limpkin/capmeter/README.md

Capacitance Meter
=================
Project in development

Things to be included with the capmeter
---------------------------------------
- <a href="http://www.ebay.com/itm/SE-N-SMD-Inductor-Test-Clip-Probe-Tweezers-for-Resistor-Multimeter-Capacitor-/111412611628">SMD tweezers</a>  
- <a href="http://www.ebay.com/itm/1Pair-For-Multimeter-Test-Equipment-Banana-Plug-To-Test-Hook-Clip-Probe-Cable-/311330430002">test hooks</a>
- one 1pF SMD capacitor
