limpkin/capmeter/bootloader/README.md

Capacitance Meter Bootloader
=============================

The bootloader found here (atxmega16a4u_104_modified.hex) has been made by modifying the Atmel provided bootloader file (atxmega16a4u_104.hex) using the following technique: http://www.hilltop-cottage.info/blogs/adam/xmega-dfu-bootloader-changing-the-sensing-pin/
