limpkin/capmeter/schematics/bom_capacitance_meter.xlsm

Project Bill Of Materials
 | Prototype quantity : | 100
Item | Schematics Ref | Qty | Price/chip | Total Price | Home Stock | Digikey Stock | Description | Manufacturer P/N | Manufacturer | Packaging | Internet link | Category | Family | (Value)
1 | U4 | 1 | 2.4824 | 2.4824 | 0 | 2775 | IC MULTIPLEXER 4X1 10MSOP | ADG804YRMZ-REEL7 | Analog Devices Inc. | 10-MSOP | http://www.digikey.com/product-detail/en/ADG804YRMZ-REEL7/ADG804YRMZ-REEL7CT-ND/3674772 | Integrated Circuits (ICs) | Interface - Analog Switches, Multiplexers, Demultiplexers
2 | U2 | 1 | 1.35 | 1.35 | 0 | 12525 | IC OPAMP GP 50MHZ RRO SOT23-5 | OPA365AIDBVR | Texas Instruments | SOT-23-5 | http://www.digikey.com/product-detail/en/OPA365AIDBVR/296-20645-1-ND/1133683 | Integrated Circuits (ICs) | Linear - Amplifiers - Instrumentation, OP Amps, Buffer Amps
3 | U7 | 1 | 1.4637 | 1.4637 | 0 | 74 | IC OPAMP LOW POWER SOT23-6 | MAX44284HAUT+T | Maxim Integrated | SOT-23-6 | http://www.digikey.com/product-detail/en/MAX44284HAUT%2BT/MAX44284HAUT%2BTCT-ND/4967871 | Integrated Circuits (ICs) | Linear - Amplifiers - Instrumentation, OP Amps, Buffer Amps
4 | U5 U8 | 2 | 2.29 | 4.58 | 0 | 14680 | IC REG LDO ADJ 0.15A 8MSOP | TPS7A4901DGNR | Texas Instruments | 8-MSOP-PowerPad | http://www.digikey.com/product-detail/en/TPS7A4901DGNR/296-27751-1-ND/2361068 | Integrated Circuits (ICs) | PMIC - Voltage Regulators - Linear
5 | U1 | 1 | 1.02 | 1.02 | 0 | 10071 | IC REG BOOST ADJ 1A SYNC 10-LLP | LM4510SD/NOPB | Texas Instruments | 10-SON (3x3) | http://www.digikey.com/product-detail/en/LM4510SD%2FNOPB/LM4510SD%2FNOPBCT-ND/1679844 | Integrated Circuits (ICs) | PMIC - Voltage Regulators - DC DC Switching Regulators
6 | U3 | 1 | 0.3584 | 0.3584 | 0 | 10944 | IC VREF SHUNT ADJ SOT23-3 | TS3431CILT | STMicroelectronics | SOT-23-3 | http://www.digikey.com/product-detail/en/TS3431CILT/497-4637-1-ND/806501 | Integrated Circuits (ICs) | PMIC - Voltage Reference
7 | U10 | 1 | 0.8058 | 0.8058 | 0 | 10801 | IC VREF SHUNT ADJ TSOT23-5 | CAT102TDI-GT3 | ON Semiconductor | TSOT-23-5 | http://www.digikey.com/product-detail/en/CAT102TDI-GT3/CAT102TDI-GT3OSCT-ND/3487509 | Integrated Circuits (ICs) | PMIC - Voltage Reference
8 | U6 | 1 | 2.5498 | 2.5498 | 0 | 9928 | IC MCU 8BIT 16KB FLASH 44VQFN | ATXMEGA16A4U-MHR | Atmel | 44-VQFN (7x7) | http://www.digikey.com/product-detail/en/ATXMEGA16A4U-MHR/ATXMEGA16A4U-MHRCT-ND/3441033 | Integrated Circuits (ICs) | Embedded - Microcontrollers
9 | U11 | 1 | 3.13 | 3.13 |  | 10217 | IC COMPARATOR R-R HI-SPD SOT23-8 | TLV3502AIDCNT | Texas Instruments | SOT-23-8 | http://www.digikey.com/product-detail/en/TLV3502AIDCNT/296-18147-1-ND/773322 | Integrated Circuits (ICs) | Linear - Comparators
10 | U12 | 1 | 0.134 | 0.134 |  | 21783 | IC GATE AND 1CH 2-INP SC-70-5 | SN74LVC1G08DCKR | Texas Instruments | 5-TSSOP, SC-70-5, SOT-353 | http://www.digikey.com/product-detail/en/SN74LVC1G08DCKR/296-11602-1-ND/385741 | Integrated Circuits (ICs) | Logic - Gates and Inverters
11 | D2 D4 | 2 | 0.2305 | 0.461 | 0 | 10598 | TVS DIODE 24VWM 76VC SOT23 | PESD24VU1UT,215 | NXP Semiconductors | SOT-23 (TO-236AB) | http://www.digikey.com/product-detail/en/PESD24VU1UT,215/568-4039-1-ND/1530829 | Circuit Protection | TVS - Diodes
12 | U9 | 1 | 0.2633 | 0.2633 | 0 | 49052 | TVS DIODE 5.5VWM 6TSOP | IP4234CZ6,125 | NXP Semiconductors | 6-TSOP | http://www.digikey.com/product-detail/en/IP4234CZ6,125/568-5869-1-ND/2531156 | Circuit Protection | TVS - Diodes
13 | CON1 | 1 | 0.3032 | 0.3032 | 0 | 88133 | Connector Receptacle USB - micro B 2.0 5 Position Surface Mount, Right Angle, Horizontal | 10118194-0001LF | FCI |  | http://www.digikey.com/product-detail/en/10118194-0001LF/609-4618-1-ND/2785382 | Connectors, Interconnects | USB, DVI, HDMI Connectors
14 | NOT POPULATED | 2 | 4.5 | 9 | 0 | 147 | SOCKET SCREW-IN SAFETY RED | BU-31607-2 | Mueller Electric Co |  | http://www.digikey.com/product-detail/en/BU-31607-2/314-1218-ND/2688311 | Connectors, Interconnects | Banana and Tip Connectors - Jacks, Plugs
15 | NOT POPULATED | 2 | 4.5 | 9 | 0 | 182 | SOCKET SCREW-IN SAFETY BLACK | BU-31607-0 | Mueller Electric Co |  | http://www.digikey.com/product-detail/en/BU-31607-0/314-1217-ND/2688310 | Connectors, Interconnects | Banana and Tip Connectors - Jacks, Plugs
16 | Q4 | 1 | 0.2117 | 0.2117 | 0 | 109281 | MOSFET P-CH 20V 2.2A SOT23-3 | SI2301BDS-T1-E3 | Vishay Siliconix | SOT-23-3 (TO-236) | http://www.digikey.com/product-detail/en/SI2301BDS-T1-E3/SI2301BDS-T1-E3CT-ND/1656835 | Discrete Semiconductor Products | FETs - Single
17 | Q1 Q2 Q3 Q5 | 4 | 0.1468 | 0.5872 | 0 | 20844 | MOSFET N-CH 20V 0.1A VMT3 | RUM001L02T2CL | Rohm Semiconductor | VMT3 | http://www.digikey.com/product-detail/en/RUM001L02T2CL/RUM001L02T2CLCT-ND/4571412 | Discrete Semiconductor Products | FETs - Single
18 | D1 | 1 | 0.2102 | 0.2102 | 0 | 189027 | DIODE SCHOTTKY 20V 1A SOD123F | PMEG2010AEH,115 | NXP Semiconductors | SOD-123F | http://www.digikey.com/product-detail/en/PMEG2010AEH,115/568-4112-1-ND/1589927 | Discrete Semiconductor Products | Diodes, Rectifiers - Single
19 | X1 | 1 | 0.6255 | 0.6255 | 0 | 15064 | Crystal 32.7680kHz 10ppm 12.5pF 70 kOhm -40°C - 85°C Surface Mount 1206 (3216 Metric) | CM315D32768EZFT | Citizen Finedevice Co Ltd | 1206 (3216 Metric) | http://www.digikey.com/product-detail/en/CM315D32768EZFT/300-8816-1-ND/3641389 | Crystals and Oscillators | Crystals | 12.5pF
20 | C37 | 1 | 0.2387 | 0.2387 | 0 | 40636 | CAP ALUM 330UF 20% 25V SMD | UWT1E331MNL1GS | Nichicon | Radial, Can - SMD | http://www.digikey.com/product-detail/en/UWT1E331MNL1GS/493-2193-1-ND/590168 | Capacitors | Aluminum Capacitors | 330µF
21 | C2 C5 C27 C31 C32 C35 C36 C38 | 8 | 0.06226 | 0.49808 | 0 | 362972 | CAP CER 10UF 16V X5R 0805 | CL21A106KOQNNNE | Samsung Electro-Mechanics America, Inc. | 0805 (2012 Metric) | http://www.digikey.com/product-detail/en/CL21A106KOQNNNE/1276-1096-1-ND/3889182 | Capacitors | Ceramic Capacitors | 10µF
22 | C10 C11 C20 C22 C23 | 5 | 0.06758 | 0.3379 | 0 | 329508 | CAP CER 10UF 25V X5R 1206 | CL31A106KAHNNNE | Samsung Electro-Mechanics America, Inc. | 1206 (3216 Metric) | http://www.digikey.com/product-detail/en/CL31A106KAHNNNE/1276-1075-1-ND/3889161 | Capacitors | Ceramic Capacitors | 10µF
23 | C6 C28 C33 | 3 | 0.0187 | 0.0561 | 0 | 394394 | CAP CER 1UF 10V X7R 0603 | CL10B105KP8NNNC | Samsung Electro-Mechanics America, Inc. | 0603 (1608 Metric) | http://www.digikey.com/product-detail/en/CL10B105KP8NNNC/1276-1946-1-ND/3890032 | Capacitors | Ceramic Capacitors | 1µF
24 | C1 C3 C8 C12 C13 C14 C15 C18 C19 C34 C39 C40 C41 C42 | 14 | 0.00681 | 0.09534 | 0 | 7307571 | CAP CER 0.1UF 50V X7R 0603 | CL10B104KB8NNNC | Samsung Electro-Mechanics America, Inc. | 0603 (1608 Metric) | http://www.digikey.com/product-detail/en/CL10B104KB8NNNC/1276-1000-1-ND/3889086 | Capacitors | Ceramic Capacitors | 0.1µF
25 | C4 C16 C17 C29 C30 | 5 | 0.0059 | 0.0295 | 0 | 632752 | CAP CER 10000PF 50V X7R 0603 | CL10B103KB8NCNC | Samsung Electro-Mechanics America, Inc. | 0603 (1608 Metric) | http://www.digikey.com/product-detail/en/CL10B103KB8NCNC/1276-1921-1-ND/3890007 | Capacitors | Ceramic Capacitors | 10000pF
26 | C26 | 1 | 0.0118 | 0.0118 | 0 | 145080 | CAP CER 4700PF 50V X7R 0603 | CL10B472KB8SFNC | Samsung Electro-Mechanics America, Inc. | 0603 (1608 Metric) | http://www.digikey.com/product-detail/en/CL10B472KB8SFNC/1276-2066-1-ND/3890152 | Capacitors | Ceramic Capacitors | 4700pF
27 | C9 | 1 | 0.0132 | 0.0132 | 0 | 207490 | CAP CER 2200PF 50V X7R 0603 | CL10B222KB8SFNC | Samsung Electro-Mechanics America, Inc. | 0603 (1608 Metric) | http://www.digikey.com/product-detail/en/CL10B222KB8SFNC/1276-1992-1-ND/3890078 | Capacitors | Ceramic Capacitors | 2200pF
28 | C21 | 1 | 0.0121 | 0.0121 | 0 | 561107 | CAP CER 100PF 50V NP0 0603 | CL10C101JB8NNNC | Samsung Electro-Mechanics America, Inc. | 0603 (1608 Metric) | http://www.digikey.com/product-detail/en/CL10C101JB8NNNC/1276-1008-1-ND/3889094 | Capacitors | Ceramic Capacitors | 100pF
29 | C7 | 1 | 0.0121 | 0.0121 | 0 | 299855 | CAP CER 15PF 50V NP0 0603 | CL10C150JB8NNNC | Samsung Electro-Mechanics America, Inc. | 0603 (1608 Metric) | http://www.digikey.com/product-detail/en/CL10C150JB8NNNC/1276-1296-1-ND/3889382 | Capacitors | Ceramic Capacitors | 15pF
30 | L1 | 1 | 0.2243 | 0.2243 | 0 | 122811 | FIXED IND 4.7UH 3A 40.3 MOHM SMD | NR6028T4R7M | Taiyo Yuden | - | http://www.digikey.com/product-detail/en/NR6028T4R7M/587-2100-1-ND/1866240 | Inductors, Coils, Chokes | Fixed Inductors | 4.7µH
31 | R24 | 1 | 0.0071 | 0.0071 | 0 | 1176822 | RES SMD 1M OHM 5% 1/10W 0603 | ERJ-3GEYJ105V | Panasonic Electronic Components | 603 | http://www.digikey.com/product-detail/en/ERJ-3GEYJ105V/P1.0MGCT-ND/134885 | Resistors | Chip Resistor - Surface Mount | 1M
32 | R7 | 1 | 0.0084 | 0.0084 | 0 | 26809 | RES SMD 255K OHM 1% 1/10W 0603 | ERJ-3EKF2553V | Panasonic Electronic Components | 603 | http://www.digikey.com/product-detail/en/ERJ-3EKF2553V/P255KHCT-ND/198279 | Resistors | Chip Resistor - Surface Mount | 255k
33 | R16 | 1 | 0.1612 | 0.1612 | 0 | 117942 | RES SMD 100K OHM 0.1% 1/10W 0603 | RG1608P-104-B-T5 | Susumu | 603 | http://www.digikey.com/product-detail/en/RG1608P-104-B-T5/RG16P100KBCT-ND/1240836 | Resistors | Chip Resistor - Surface Mount | 100k
34 | R5 R8 | 2 | 0.0084 | 0.0168 | 0 | 135609 | RES SMD 46.4K OHM 1% 1/10W 0603 | ERJ-3EKF4642V | Panasonic Electronic Components | 603 | http://www.digikey.com/product-detail/en/ERJ-3EKF4642V/P46.4KHCT-ND/198400 | Resistors | Chip Resistor - Surface Mount | 46.4k
35 | R9 R33 | 2 | 0.0057 | 0.0114 | 0 | 1048463 | RES SMD 20.5K OHM 1% 1/10W 0603 | RC0603FR-0720K5L | Yageo | 603 | http://www.digikey.com/product-detail/en/RC0603FR-0720K5L/311-20.5KHRCT-ND/729989 | Resistors | Chip Resistor - Surface Mount | 20.5k
36 | R4 R17 | 2 | 0.0057 | 0.0114 | 0 | 1043691 | RES SMD 15K OHM 1% 1/10W 0603 | RC0603FR-0715KL | Yageo | 603 | http://www.digikey.com/product-detail/en/RC0603FR-0715KL/311-15.0KHRCT-ND/729900 | Resistors | Chip Resistor - Surface Mount | 15k
37 | R22 | 1 | 0.1924 | 0.1924 | 0 | 81686 | RES SMD 15K OHM 0.1% 1/10W 0603 | ERA-3AEB153V | Panasonic Electronic Components | 603 | http://www.digikey.com/product-detail/en/ERA-3AEB153V/P15KDBCT-ND/1466080 | Resistors | Chip Resistor - Surface Mount | 15k
38 | R15 | 1 | 0.1612 | 0.1612 | 0 | 353464 | RES SMD 10K OHM 0.1% 1/10W 0603 | RG1608P-103-B-T5 | Susumu | 603 | http://www.digikey.com/product-detail/en/RG1608P-103-B-T5/RG16P10.0KBCT-ND/1240835 | Resistors | Chip Resistor - Surface Mount | 10k
39 | R1 R11 R12 R19 R25 R28 R31 R32 R38 | 9 | 0.00348 | 0.03132 | 0 | 10884953 | RES SMD 10K OHM 1% 1/10W 0603 | RC0603FR-0710KL | Yageo | 603 | http://www.digikey.com/product-detail/en/RC0603FR-0710KL/311-10.0KHRCT-ND/729827 | Resistors | Chip Resistor - Surface Mount | 10k
40 | R34 R35 | 2 | 0.0057 | 0.0114 |  | 186024 | RES SMD 5.49K OHM 1% 1/10W 0603 | RC0603FR-075K49L | Yageo | 603 | http://www.digikey.com/product-detail/en/RC0603FR-075K49L/311-5.49KHRCT-ND/730221 | Resistors | Chip Resistor - Surface Mount | 5.49k
41 | R26 | 1 | 0.0084 | 0.0084 | 0 | 93154 | RES SMD 2.15K OHM 1% 1/10W 0603 | ERJ-3EKF2151V | Panasonic Electronic Components | 603 | http://www.digikey.com/product-detail/en/ERJ-3EKF2151V/P2.15KHCT-ND/198222 | Resistors | Chip Resistor - Surface Mount | 2.15k
42 | R2 R10 R18 R27 R29 R37 | 6 | 0.00514 | 0.03084 | 0 | 238457 | RES SMD 1.2K OHM 1% 1/10W 0603 | ERJ-3EKF1201V | Panasonic Electronic Components | 603 | http://www.digikey.com/product-detail/en/ERJ-3EKF1201V/P1.20KHCT-ND/1746727 | Resistors | Chip Resistor - Surface Mount | 1.2k
43 | R23 | 1 | 0.1924 | 0.1924 | 0 | 141597 | RES SMD 1.2K OHM 0.1% 1/10W 0603 | ERA-3AEB122V | Panasonic Electronic Components | 603 | http://www.digikey.com/product-detail/en/ERA-3AEB122V/P1.2KDBCT-ND/1466054 | Resistors | Chip Resistor - Surface Mount | 1.2k
44 | R36 | 1 | 0.0084 | 0.0084 |  | 5659865 | RES SMD 1K OHM 1% 1/10W 0603 | ERJ-3EKF1001V | Panasonic Electronic Components | 603 | http://www.digikey.com/product-detail/en/ERJ-3EKF1001V/P1.00KHCT-ND/198071 | Resistors | Chip Resistor - Surface Mount | 1k
45 | R21 | 1 | 0.1924 | 0.1924 | 0 | 136190 | RES SMD 1K OHM 0.1% 1/10W 0603 | ERA-3AEB102V | Panasonic Electronic Components | 603 | http://www.digikey.com/product-detail/en/ERA-3AEB102V/P1.0KDBCT-ND/1466052 | Resistors | Chip Resistor - Surface Mount | 1k
46 | R14 | 1 | 0.2554 | 0.2554 |  | 14275 | RES SMD 1K OHM 0.1% 1/4W 1206 | RG3216P-1001-B-T1 | Susumu | 1206 | http://www.digikey.com/product-detail/en/RG3216P-1001-B-T1/RG32P1.0KBCT-ND/2078593 | Resistors | Chip Resistor - Surface Mount | 1k
47 | R13 | 1 | 0.6187 | 0.6187 | 0 | 9696 | RES SMD 470 OHM 0.1% 1W 1206 | PRG3216P-4700-B-T5 | Susumu | 1206 | http://www.digikey.com/product-detail/en/PRG3216P-4700-B-T5/408-1862-1-ND/4917843 | Resistors | Chip Resistor - Surface Mount | 470
48 | R3 R6 R30 | 3 | 0.00436 | 0.01308 | 0 | 2031519 | RES SMD 100 OHM 1% 1/10W 0603 | RC0603FR-07100RL | Yageo | 603 | http://www.digikey.com/product-detail/en/RC0603FR-07100RL/311-100HRCT-ND/729835 | Resistors | Chip Resistor - Surface Mount | 100
49 | R20 | 1 | 0.0096 | 0.0096 | 0 | 8523170 | RES SMD 0.0OHM JUMPER 1/10W 0603 | ERJ-3GEY0R00V | Panasonic Electronic Components | 603 | http://www.digikey.com/product-detail/en/ERJ-3GEY0R00V/P0.0GCT-ND/134711 | Resistors | Chip Resistor - Surface Mount | 0
50 | FB1 | 1 | 0.0472 | 0.0472 | 0 | 607973 | FERRITE CHIP 220 OHM 2A 0603 | MPZ1608S221ATA00 | TDK Corporation | 0603 (1608 Metric) | http://www.digikey.com/product-detail/en/MPZ1608S221ATA00/445-1565-1-ND/571895 | Filters | Ferrite Beads and Chips
 | CON2 | 1 |  |  |  |  | Standard 0.1" connector 3x2
 | P6 | 1 |  |  |  |  | Standard 0.1" connector 4x1
 | C24 C25 |  |  |  |  |  | DO NOT POPULATE
 | Total: | 108 |  | 42.05436
 | Total for 10 prototypes : |  |  | 53.907
 | Total for 100 prototypes : |  |  | 42.05436 |  | Missing in Kicad: NOT_POPULATED NOT_POPULATED
 | Total for 1000 prototypes : |  |  | 32.50572 |  | Missing in BoM: P1 P2 P3 P4 P7 P8 P9
 | Total for 5000 prototypes : |  |  | 30.76193
 | Total for 10k "prototypes" : |  |  | 30.76193
