limpkin/capmeter/(threads)

Thread 2 (2015-12-15):

Macro enabled BOM is a security risk

duckythescientist, 2015-12-15:
File in question: `capmeter/schematics/bom_capacitance_meter.xlsm`

This is a macro enabled Excel spread sheet which has the ability to execute code on a host machine. I'm guessing that VB scripts in this are fully benign and probably useful/necessary for the project, but it's still a worry. Office has removed autorun capabilities for document macros, so it's not a huge issue anymore.

It would be best to remove the macro if you can maintain functionality of the document. I'm guessing the macro is integral enough that this issue should be marked "wontfix".

--------
[Why macros are dangerous](http://www.howtogeek.com/171993/macros-explained-why-microsoft-office-files-can-be-dangerous/)

[Extracting macros from documents for analysis](https://digital-forensics.sans.org/blog/2009/11/23/extracting-vb-macros-from-malicious-documents)
