limpkin/capmeter/schematics/schematics.pdf

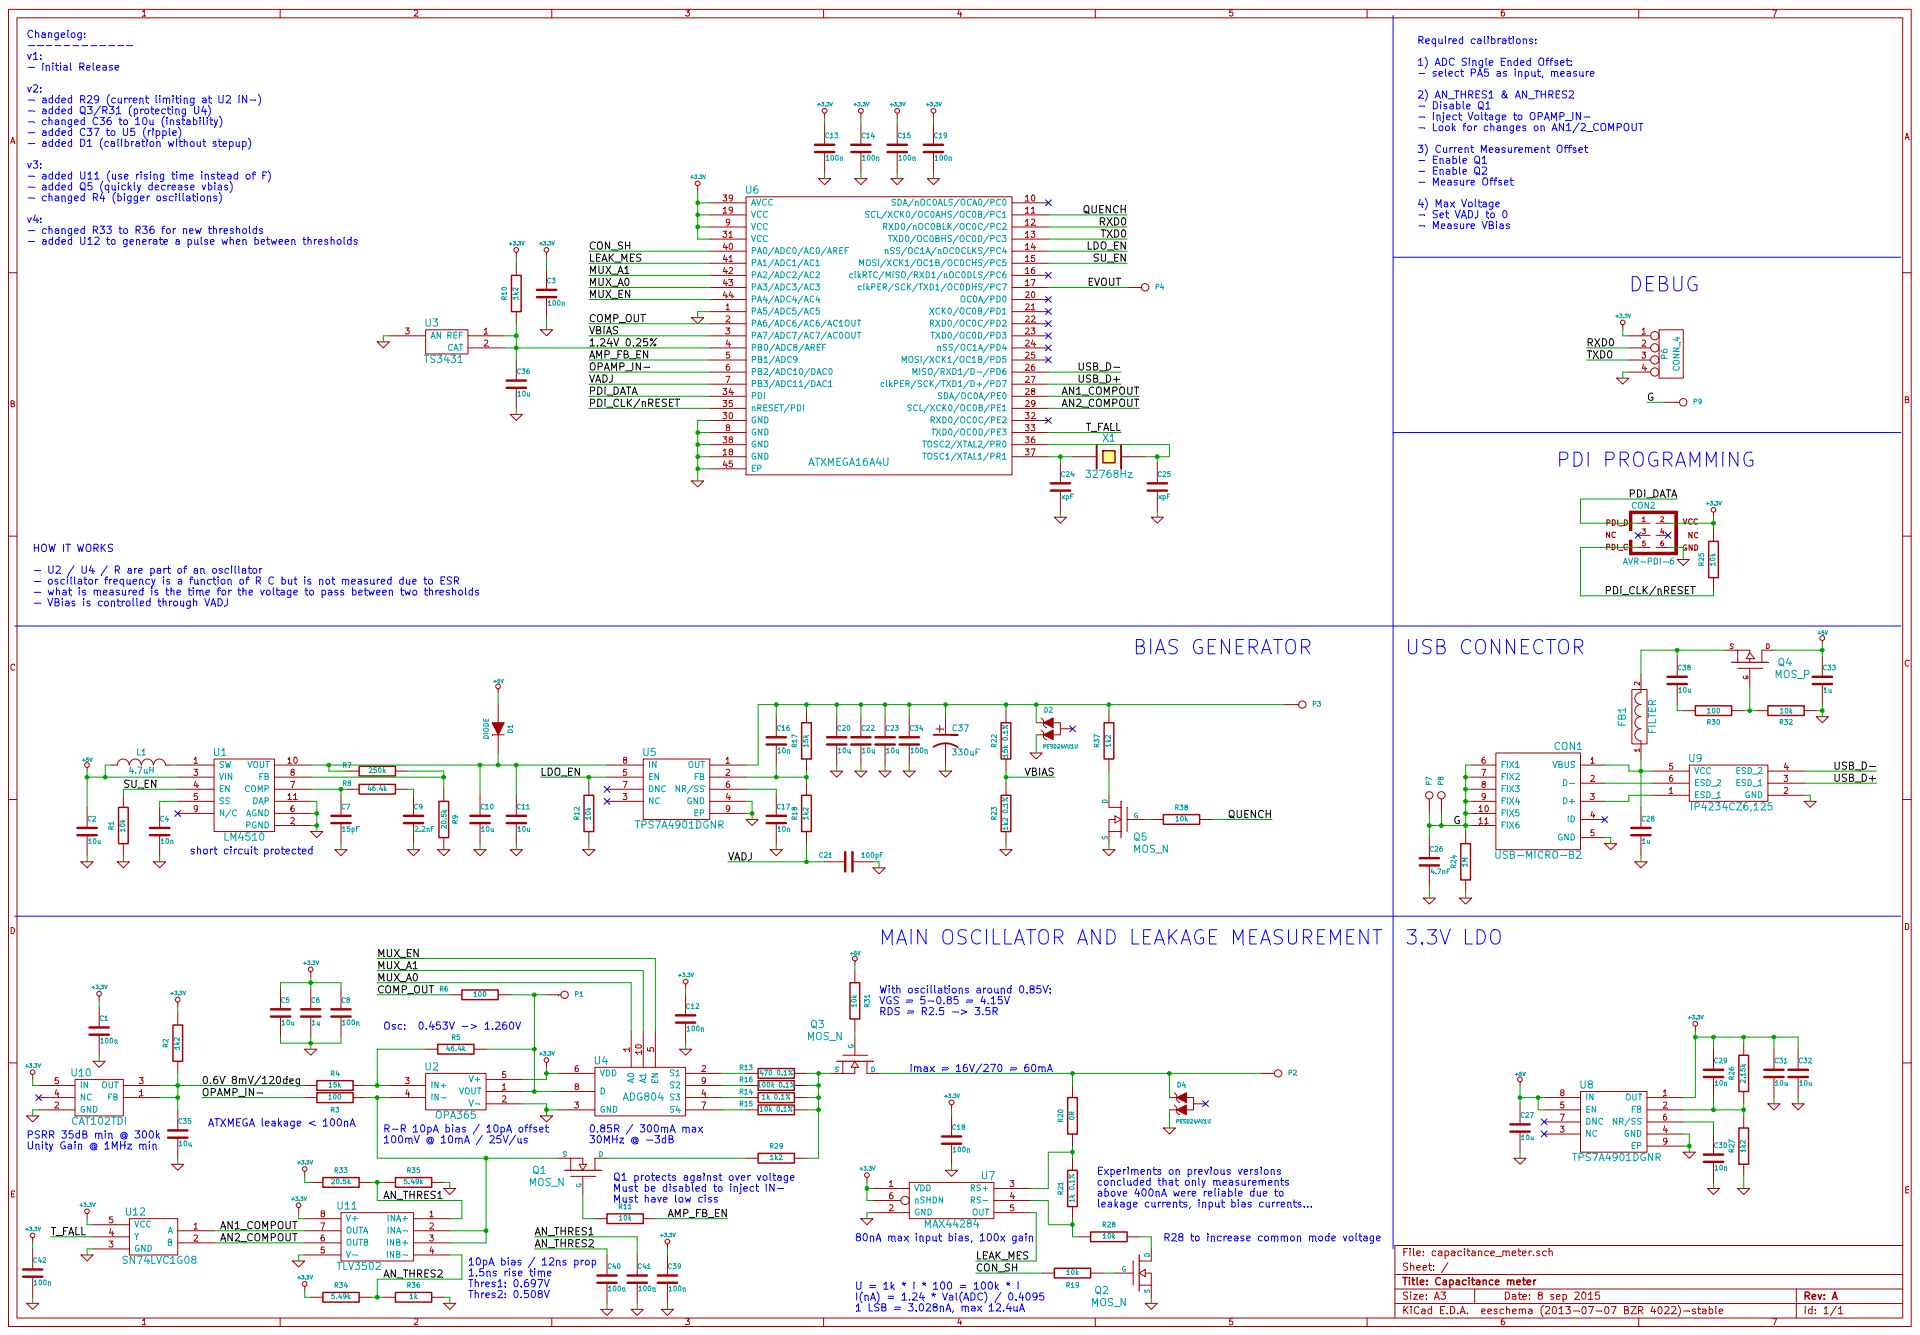
[picture p1: page 1]
