limpkin/capmeter/source_code/printf_override.h

/*
 * printf_override.h
 *
 * Created: 23/07/2015 20:11:53
 *  Author: limpkin
 */ 


#ifndef PRINTF_OVERRIDE_H_
#define PRINTF_OVERRIDE_H_

#define PRINTF_OVERRIDE
#ifdef PRINTF_OVERRIDE
    #undef IO_PRINTF
    #undef SERIAL_PRINTF
    #undef MEAS_PRINTF
    #undef DAC_PRINTF
    #undef ADC_PRINTF
    #undef CALIB_PRINTF
    #undef VBIAS_PRINTF
    #undef MAIN_PRINTF
#endif

// This file was made to facilitate automated testing through uart
//#undef AUTOMATED_TESTS_PRINTF
//#undef TESTS_PRINTF
//#undef CONV_PRINTF

#endif /* PRINTF_OVERRIDE_H_ */
