limpkin/capmeter/source_code/usb.h

/*
 *  usb.h
 *  Author: Miguel
 */
#ifndef USB_H_
#define USB_H_

#include <avr/io.h>
#include "defines.h"
#include "printf_override.h"

/* Function prototypes */
void init_usb(void);
uint8_t is_usb_enumerated(void);
void usb_send_data(uint8_t* data);
uint8_t usb_receive_data(uint8_t* data);

// USB printf
#ifdef USB_PRINTF
    #define usbdprintf   printf
    #define usbdprintf_P printf_P
#else
    #define usbdprintf
    #define usbdprintf_P
#endif

// Typedefs
typedef union USB_EP_pair
{
    union
    {
        struct
        {
            USB_EP_t out;
            USB_EP_t in;
        };
        USB_EP_t ep[2];
    };
} __attribute__ ((packed)) USB_EP_pair_t;

// Configuration descriptor, USB spec 9.6.3, page 264-266, Table 9-10
#define RAWHID_INTERFACE    0                   // Interface for the raw HID
#define RAWHID_RX_ENDPOINT  1                   // Raw HID RX endpoint
#define RAWHID_TX_ENDPOINT  2                   // Raw HID TX endpoint
#define RAWHID_TX_SIZE      64                  // Raw HID transmit packet size
#define RAWHID_RX_SIZE      64                  // Raw HID receive packet size
#define RAWHID_RX_INTERVAL  10                  // RX interval
#define RAWHID_TX_INTERVAL  10                  // TX interval
#define RAWHID_USAGE_PAGE   0xFF31              // HID usage page, after 0xFF00: vendor-defined
#define RAWHID_USAGE        0x0074              // HID usage
#define RAWHID_EP0_SIZE     64                  // Endpoint 0 size

// Command IDs defines
#define CMD_DEBUG               0x00
#define CMD_PING                0x01
#define CMD_VERSION             0x02
#define CMD_OE_CALIB_STATE      0x03
#define CMD_OE_CALIB_START      0x04
#define CMD_GET_OE_CALIB        0x05
#define CMD_SET_VBIAS           0x06
#define CMD_DISABLE_VBIAS       0x07
#define CMD_CUR_MES_MODE        0x08
#define CMD_CUR_MES_MODE_EXIT   0x09
#define CMD_CAP_REPORT_FREQ     0x0A
#define CMD_CAP_MES_START       0x0B
#define CMD_CAP_MES_REPORT      0x0C
#define CMD_CAP_MES_EXIT        0x0D
#define CMD_SET_VBIAS_DAC       0x0E
#define CMD_RESET_STATE         0x0F
#define CMD_SET_EEPROM_VALS     0x10
#define CMD_READ_EEPROM_VALS    0x11

#define CMD_BOOTLOADER_START    0xFF

#define USB_RETURN_ERROR    0
#define USB_RETURN_OK       1

/* USB Calibration Offsets */
#define USBCAL0_offset      (0x1A)
#define USBCAL1_offset      (0x1B)

#endif
