limpkin/capmeter/scripts/hid_comms.py

from array import array
from time import sleep
import platform
import usb.core
import usb.util
import os.path
import random
import struct
import string
import pickle
import copy
import time
import sys
import os

USB_VID                 = 0x1209
USB_PID                 = 0xdddd

LEN_INDEX               = 0x00
CMD_INDEX               = 0x01
DATA_INDEX              = 0x02
CMD_PING		= 0x05

		
def receiveHidPacket(epin):
	try :
		data = epin.read(epin.wMaxPacketSize, timeout=15000)
		return data
	except usb.core.USBError as e:
		#print e
		sys.exit("Capmeter didn't send a packet")

def receiveHidPacketWithTimeout(epin):
	try :
		data = epin.read(epin.wMaxPacketSize, timeout=15000)
		return data
	except usb.core.USBError as e:
		return None

def sendHidPacket(epout, cmd, len, data):
	# data to send
	arraytosend = array('B')

	# if command copy it otherwise copy the data
	if cmd != 0:
		arraytosend.append(len)
		arraytosend.append(cmd)

	# add the data
	if data is not None:
		arraytosend.extend(data)

	#print arraytosend
	#print arraytosend

	# send data
	epout.write(arraytosend)
	
def findHIDDevice(vendor_id, product_id, print_debug):
	# Find our device
	hid_device = usb.core.find(idVendor=vendor_id, idProduct=product_id)

	# Was it found?
	if hid_device is None:
		if print_debug:
			print "Device not found"
		return None, None, None, None

	# Device found
	if print_debug:
		print "Capmeter found"

	# Different init codes depending on the platform
	if platform.system() == "Linux":
		# Need to do things differently
		try:
			print ""
			hid_device.detach_kernel_driver(0)
			#hid_device.reset()
		except Exception, e:
			pass # Probably already detached
	else:
		# Set the active configuration. With no arguments, the first configuration will be the active one
		try:
			hid_device.set_configuration()
		except Exception, e:
			if print_debug:
				print "Cannot set configuration the device:" , str(e)
			return None, None, None, None

	#for cfg in hid_device:
	#	print "configuration val:", str(cfg.bConfigurationValue)
	#	for intf in cfg:
	#		print "int num:", str(intf.bInterfaceNumber), ", int alt:", str(intf.bAlternateSetting)
	#		for ep in intf:
	#			print "endpoint addr:", str(ep.bEndpointAddress)

	# Get an endpoint instance
	cfg = hid_device.get_active_configuration()
	intf = cfg[(0,0)]

	# Match the first OUT endpoint
	epout = usb.util.find_descriptor(intf, custom_match = lambda e: usb.util.endpoint_direction(e.bEndpointAddress) == usb.util.ENDPOINT_OUT)
	if epout is None:
		hid_device.reset()
		return None, None, None, None
	#print "Selected OUT endpoint:", epout.bEndpointAddress

	# Match the first IN endpoint
	epin = usb.util.find_descriptor(intf, custom_match = lambda e: usb.util.endpoint_direction(e.bEndpointAddress) == usb.util.ENDPOINT_IN)
	if epin is None:
		hid_device.reset()
		return None, None, None, None
	#print "Selected IN endpoint:", epin.bEndpointAddress

	# prepare ping packet
	byte1 = random.randint(0, 255)
	byte2 = random.randint(0, 255)
	ping_packet = array('B')
	ping_packet.append(2)
	ping_packet.append(CMD_PING)
	ping_packet.append(byte1)
	ping_packet.append(byte2)

	time.sleep(0.5)
	try:
		# try to send ping packet
		epout.write(ping_packet)
		# try to receive one answer
		temp_bool = 0
		while temp_bool == 0:
			try :
				# try to receive answer
				data = epin.read(epin.wMaxPacketSize, timeout=2000)
				if data[CMD_INDEX] == CMD_PING and data[DATA_INDEX] == byte1 and data[DATA_INDEX+1] == byte2 :
					temp_bool = 1
					if print_debug:
						print "Capmeter replied to our ping message"
				else:
					if print_debug:
						print "Cleaning remaining input packets"
				time.sleep(.5)
			except usb.core.USBError as e:
				if print_debug:
					print e
				return None, None, None, None
	except usb.core.USBError as e:
		if print_debug:
			print e
		return None, None, None, None

	# Return device & endpoints
	return hid_device, intf, epin, epout

if __name__ == '__main__':
	# Main function
	print ""
	print "Capmeter USB client"

	# Search for the Capmeter and read hid data
	hid_device, intf, epin, epout = findHIDDevice(USB_VID, USB_PID, True)

	if hid_device is None:
		sys.exit(0)

	choice = 1
	while choice != 0:
		# print use
		print ""
		print "0) Quit"
		choice = input("Make your choice: ")
		print ""

		if choice == 1:
			print "pouet"

	hid_device.reset()
