limpkin/capmeter/source_code/tests.c

/*
 * tests.c
 *
 * Created: 24/07/2015 18:11:32
 *  Author: limpkin
 */ 
#include <avr/pgmspace.h>
#include <avr/eeprom.h>
#include <util/delay.h>
#include <avr/io.h>
#include <string.h>
#include <stdio.h>
#include "eeprom_addresses.h"
#include "conversions.h"
#include "calibration.h"
#include "measurement.h"
#include "meas_io.h"
#include "utils.h"
#include "vbias.h"
#include "tests.h"
#include "usb.h"
#include "dac.h"
#include "adc.h"

/*
 * To measure set voltages
 */
void functional_test(void)
{
    if (eeprom_read_byte((uint8_t*)EEP_FUNC_TEST_DONE_BOOL) == EEPROM_BOOL_OK_VAL)
    {
        // If functional test has already been done, return
        return;
    }        
    
    // Start by calibrating the platform
    testdprintf_P(PSTR("Calibration in progress, please wait...\r\n"));
    start_openended_calibration(0,0,0);
    
    testdprintf_P(PSTR("\r\n\r\n\r\n\r\n--------------------------\r\n"));
    testdprintf_P(PSTR("--- FUNCTIONAL TESTING ---\r\n"));
    testdprintf_P(PSTR("-\r\n"));
    uint8_t test_passed = TRUE;
    
    /*******************************************************************/
    /*******************************************************************/
    /******************** CHECK THE SINGLE ENDED OFFSET ****************/
    /*******************************************************************/
    /*******************************************************************/
    if (check_value_range(get_single_ended_offset(ADC_CHANNEL_GND_EXT), 160, 190) == FALSE)
    {
        testdprintf("- PROBLEM OFFSET: %u\r\n", get_single_ended_offset(ADC_CHANNEL_GND_EXT));
        testdprintf_P(PSTR("  Likely suspects: bad MCU\r\n"));
        test_passed = FALSE;
    } 
    else
    {
        testdprintf("- OK OFFSET: %u\r\n", get_single_ended_offset(ADC_CHANNEL_GND_EXT));
    }
    if (check_value_range(get_single_ended_offset(ADC_CHANNEL_VBIAS), 160, 190) == FALSE)
    {
        testdprintf("- PROBLEM OFFSET VBIAS: %u\r\n", get_single_ended_offset(ADC_CHANNEL_VBIAS));
        testdprintf_P(PSTR("  Likely suspects: bad MCU or defective U5/R22/R23\r\n"));
        test_passed = FALSE;
    } 
    else
    {
        testdprintf("- OK OFFSET VBIAS: %u\r\n", get_single_ended_offset(ADC_CHANNEL_VBIAS));
    }
    
    /*******************************************************************/
    /*******************************************************************/
    /********************* CHECK MAX VOLTAGE ***************************/
    /*******************************************************************/
    /*******************************************************************/
    if (get_max_vbias_voltage() < 15000)
    {
        testdprintf("- PROBLEM MAX VOLTAGE: %u\r\n", get_max_vbias_voltage());
        testdprintf_P(PSTR("  Likely suspects: U1, U5 and their passives\r\n"));
        test_passed = FALSE;
    } 
    else
    {
        testdprintf("- OK MAX VOLTAGE: %u\r\n", get_max_vbias_voltage());
    }
    
    /*******************************************************************/
    /*******************************************************************/
    /********************* CHECK THRESHOLD 1 ***************************/
    /*******************************************************************/
    /*******************************************************************/
    // Thres1: Vthres = 3.3V * 5.49 / (5.49 + 20.5)
    // Taking into account 1% tolerances, but not 1.24V ref tolerance
    // low: 3.3*0.99*5.49*0.99 / (5.49 * 0.99 + 20.5 * 1.01)
    // high: 3.3*1.01*5.49*1.01 / (5.49 * 1.01 + 20.5 * 0.99)
    // dac values: Vdac = Val(DAC) * 1.24 / 4095 >> Val(DAC) = Vdac * 4095 / 1.24
    // low: 3.3*0.99*5.49*0.99*4095 / ((5.49 * 0.99 + 20.5 * 1.01) * 1.24) = 2243
    // high: 3.3*1.01*5.49*1.01*4095 / ((5.49 * 1.01 + 20.5 * 0.99) * 1.24) = 2362
    if (check_value_range(get_calib_first_thres_down(), 2243, 2362) == FALSE)
    {
        testdprintf("- PROBLEM FIRST THRES DOWN: %u\r\n", get_calib_first_thres_down());
        testdprintf_P(PSTR("  Likely suspects: U11 R33 R35\r\n"));
        test_passed = FALSE;
    }
    else
    {
        testdprintf("- OK FIRST THRES DOWN: %u\r\n", get_calib_first_thres_down());
    }
    if (check_value_range(get_calib_first_thres_up(), 2243, 2362) == FALSE)
    {
        testdprintf("- PROBLEM FIRST THRES UP: %u\r\n", get_calib_first_thres_up());
        testdprintf_P(PSTR("  Likely suspects: U11 R33 R35\r\n"));
        test_passed = FALSE;
    }
    else
    {
        testdprintf("- OK FIRST THRES UP: %u\r\n", get_calib_first_thres_up());
    }
    
    /*******************************************************************/
    /*******************************************************************/
    /********************* CHECK THRESHOLD 2 ***************************/
    /*******************************************************************/
    /*******************************************************************/
    // Thres2: Vthres = 3.3V * 1 / (1 + 5.49)
    // Taking into account 1% tolerances, but not 1.24V ref tolerance
    // low: 3.3*0.99*1*0.99 / (1 * 0.99 + 5.49 * 1.01)
    // high: 3.3*1.01*1*1.01 / (1 * 1.01 + 5.49 * 0.99)
    // dac values: Vdac = Val(DAC) * 1.24 / 4095 >> Val(DAC) = Vdac * 4095 / 1.24
    // low: 3.3*0.99*1*0.99*4095 / ((1 * 0.99 + 5.49 * 1.01) * 1.24) = 1634
    // high: 3.3*1.01*1*1.01*4095 / ((1 * 1.01 + 5.49 * 0.99) * 1.24) = 1725
    if (check_value_range(get_calib_second_thres_down(), 1634, 1725) == FALSE)
    {
        testdprintf("- PROBLEM SECOND THRES DOWN: %u\r\n", get_calib_second_thres_down());
        testdprintf_P(PSTR("  Likely suspects: U11 R34 R36\r\n"));
        test_passed = FALSE;
    }
    else
    {
        testdprintf("- OK SECOND THRES DOWN: %u\r\n", get_calib_second_thres_down());
    }
    if (check_value_range(get_calib_second_thres_up(), 1634, 1725) == FALSE)
    {
        testdprintf("- PROBLEM SECOND THRES UP: %u\r\n", get_calib_second_thres_up());
        testdprintf_P(PSTR("  Likely suspects: U11 R34 R36\r\n"));
        test_passed = FALSE;
    }
    else
    {
        testdprintf("- OK SECOND THRES UP: %u\r\n", get_calib_second_thres_up());
    }
    
    /*******************************************************************/
    /*******************************************************************/
    /******************* CHECK OSCILLATOR LOW V VALUE *****************/
    /*******************************************************************/
    /*******************************************************************/
    // Oscillator low value: Vosclow = 0.6V * 46.4 / (15 + 46.4)
    // Taking into account 1% tolerances, but not 1.24V ref tolerance
    // low: 0.6*0.99*46.4*0.99 / (46.4 * 0.99 + 15 * 1.01)
    // high: 0.6*1.01*46.4*1.01 / (46.4 * 1.01 + 15 * 0.99)
    // dac values: Vdac = Val(DAC) * 1.24 / 4095 >> Val(DAC) = Vdac * 4095 / 1.24
    // low: 0.6*0.99*46.4*0.99*4095 / ((46.4 * 0.99 + 15 * 1.01) * 1.24) = 1475
    // high: 0.6*1.01*46.4*1.01*4095 / ((46.4 * 1.01 + 15 * 0.99) * 1.24) = 1520
    if (check_value_range(get_calib_osc_low_v(), 1475, 1520) == FALSE)
    {
        testdprintf("- PROBLEM OSC LOW V: %u\r\n", get_calib_osc_low_v());
        testdprintf_P(PSTR("  Likely suspects: U2 R4 R5 U10 R2\r\n"));
        test_passed = FALSE;
    }
    else
    {
        testdprintf("- OK OSC LOW V: %u\r\n", get_calib_osc_low_v());
    }
    
    /*******************************************************************/
    /*******************************************************************/
    /********************* AND GATE CHECKING ***************************/
    /*******************************************************************/
    /*******************************************************************/
    uint8_t and_gate_test_passed = TRUE;                                                    // Boolean to store test result
    disable_feedback_mos();                                                                 // Disable feedback mos
    opampin_as_input();                                                                     // Opampin as input
    _delay_ms(10);                                                                          // Wait
    setup_opampin_dac(get_calib_first_thres_down() + 200);                                  // Set opampin outside the AND range
    _delay_ms(10);                                                                          // Wait
    if ((PORTE_IN & PIN3_bm) != 0)                                                          // AND gate output should be 0
    {
        and_gate_test_passed = FALSE;
        testdprintf_P(PSTR("- AND STEP1 PROBLEM\r\n"));
    }
    update_opampin_dac((get_calib_second_thres_down() + get_calib_first_thres_up())/2);     // Set opampin between thresholds
    _delay_ms(10);                                                                          // Wait
    if ((PORTE_IN & PIN3_bm) == 0)                                                          // AND gate output should be 1
    {
        and_gate_test_passed = FALSE;
        testdprintf_P(PSTR("- AND STEP2 PROBLEM\r\n"));
    }
    update_opampin_dac(get_calib_second_thres_up() - 200);                                  // Set opampin outside the AND range
    _delay_ms(10);                                                                          // Wait
    if ((PORTE_IN & PIN3_bm) != 0)                                                          // AND gate output should be 0
    {
        and_gate_test_passed = FALSE;
        testdprintf_P(PSTR("- AND STEP3 PROBLEM\r\n"));
    }
    // Tests done, check boolean
    if (and_gate_test_passed == FALSE)
    {
        testdprintf_P(PSTR("- PROBLEM AND GATE\r\n"));
        testdprintf_P(PSTR("  Likely suspects: U12\r\n"));
        test_passed = FALSE;
    }
    else
    {
        testdprintf_P(PSTR("- OK AND GATE & THRESHOLDS\r\n"));
    }
    disable_opampin_dac();
    set_opampin_low();
    
    /*******************************************************************/
    /*******************************************************************/
    /************************ COMPOUTS OUTPUTS *************************/
    /*******************************************************************/
    /*******************************************************************/
    _delay_ms(10);
    uint8_t compouts_test_passed = TRUE;
    if (((PORTE_IN & (PIN0_bm|PIN1_bm)) != (PIN0_bm)) || ((PORTA_IN & PIN6_bm) == 0))
    {
        compouts_test_passed = FALSE;
    }
    set_opampin_high();
    _delay_ms(10);
    if (((PORTE_IN & (PIN0_bm|PIN1_bm)) != (PIN1_bm)) || ((PORTA_IN & PIN6_bm) != 0))
    {
        compouts_test_passed = FALSE;
    }
    if(compouts_test_passed != TRUE)
    {
        testdprintf_P(PSTR("- PROBLEM COMPOUT outputs: check U6\r\n"));
        test_passed = FALSE;
    }
    else
    {
        testdprintf_P(PSTR("- OK COMPOUT OUTPUTS\r\n"));
    }
    set_opampin_low();
    
    /*******************************************************************/
    /*******************************************************************/
    /************************ AVCC CHECK *******************************/
    /*******************************************************************/
    /*******************************************************************/
    // Check AVCC, select ADC channel for AVCC / 10
    // Vadc = Val(ADC) * (1.24 / 4095)
    // Val(ADC) = Vadc * (4095 / 1.24+-0.25%)
    // From http://atmel.force.com/support/articles/en_US/FAQ/Accuracy-of-Vcc-Scaled?q=xmega+adc&l=en_US&fs=Search&pn=1, error is +-1mV hence +-4LSB
    // Vadc is the 3.3V / 10
    // Vout = Vref (R1 + R2) / R2
    // Min Vout = 1.176 * (2.15 * 0.99 + 1.2 * 1.01) / (1.2 * 1.01) = 3.241V
    // Val(ADC)min = ((1.176 * (2.15 * 0.99 + 1.2 * 1.01) / (1.2 * 1.01)) - 0.001) * (409.5 / (1.24*1.0025)) - 3 = 1064
    // Max Vout = 1.212 * (2.15 * 1.01 + 1.2 * 0.99) / (1.2 * 0.99) = 3.427V
    // Val(ADC)max = ((1.212 * (2.15 * 1.01 + 1.2 * 0.99) / (1.2 * 0.99)) + 0.001) * (409.5 / (1.24*0.9975)) + 3 = 1138
    configure_adc_channel(ADC_CHANNEL_AVCCDIV10, 0, FALSE);
    uint16_t avcc = get_averaged_adc_value(13);
    if (check_value_range(avcc, 1064, 1138) == FALSE)
    {
        testdprintf("- PROBLEM AVCC: %u (~%umV)\r\n", avcc, compute_voltage_from_se_adc_val(avcc)*10);
        testdprintf_P(PSTR("  Likely suspects: U8 R26 R27\r\n"));
        test_passed = FALSE;
    }
    else
    {
        testdprintf("- OK AVCC: %u (~%umV)\r\n", avcc, compute_voltage_from_se_adc_val(avcc)*10);
    }
    
    /*******************************************************************/
    /*******************************************************************/
    /*************************** VREF CHECK ****************************/
    /*******************************************************************/
    /*******************************************************************/
    // Vadc = Val(ADC) * AVcc / 1.6 * 4095
    // Following a ticket with Atmel, Avcc / 1.6 is only 1% precise. x is the error
    // Vadc = Val(ADC) * Avcc * x / 1.6 * 4095
    // Val(ADC) = Vadc * (6552 / AVcc * x)
    // Val(ADC) = 1.24 * (6552 / AVcc * x)
    // Avcc is avcc from before * 10 * 1.24 / 4095...
    // Val(ADC) = 1.24+-0.25% * 6552 / (10 * avcc * (1.24+-0.25% / 4095) * x)
    // Val(ADC) = 6552 * 4095 / 10 * avcc * x
    // Val(ADC) = 2683044 / avcc * x
    // Val(ADC) * avcc = 2683044 / x >> x is 0.99 & 1.01 >> 2656479 & 2710146
    // Avcc error can be 3 LSB, we'll put 10 though as the offset isn't exactly the same between channels!
    delete_single_ended_offset();                                                   // Delete single ended offset as we switch references
    configure_adc_channel(ADC_CHANNEL_GND_EXT_VCCDIV16, 0, FALSE);                  // Select GND pin to measure the new offset
    uint16_t aref_offset = get_averaged_adc_value(13);                              // Measure the offset
    configure_adc_channel(ADC_CHANNEL_AREF, 0, FALSE);                              // Select aref channel
    uint16_t aref = get_averaged_adc_value(13);                                     // Measure aref value
    configure_adc_channel(ADC_CHANNEL_AVCCDIV10_VCCDIV16, 0, FALSE);                // Select avcc/10 channel with VCC/1.6 as reference
    //uint16_t div10_avccint_ref = get_averaged_adc_value(13);                      // Measure avcc/10
    uint32_t min_total = ((uint32_t)(aref-aref_offset)-11)*((uint32_t)avcc-11-5);   // Min multiplication
    uint32_t max_total = ((uint32_t)(aref-aref_offset)+11)*((uint32_t)avcc+11+5);   // Max multiplication value
    if ((max_total < 2656479) || (min_total > 2710146))
    {
        testdprintf("- PROBLEM AREF: %u (~%umV)\r\n", aref-aref_offset, compute_voltage_from_se_adc_val_with_avcc_div16_ref(aref-aref_offset));
        testdprintf("  min_total = %"PRIu32", max_total = %"PRIu32"\r\n", min_total, max_total);
        testdprintf_P(PSTR("  Likely suspects: U3 or U8 and passives\r\n"));
        test_passed = FALSE;
    }
    else
    {
        testdprintf("- OK AREF: %u (~%umV)\r\n", aref-aref_offset, compute_voltage_from_se_adc_val_with_avcc_div16_ref(aref-aref_offset));
    }
    calibrate_single_ended_offset();
    
    /*******************************************************************/
    /*******************************************************************/
    /***************** CHECK VBIAS GENERATION WITH LDO ****************/
    /*******************************************************************/
    /*******************************************************************/
    // Vref = VR2 + Vdac
    // VR2 = (Vout - Vdac) * R2 / (R1 + R2)
    // Vout = Vref * (R1 + R2) / R2 - Vdac * R1 / R2
    // Vref between 1.176 and 1.212, components resistance are 1% accurate
    // For perfect value:
    // Vout = 1.188 * 16.2 / 1.2 - Vdac * 15 / 1.2
    // Vout = 16.038 - Val(DAC) * (1.24 / 4095) * (15 / 1.2)
    // Vout = 16,038 - Val(DAC) * 0,0037851
    // For 3210 : 3.888
    // for minimum (vdac never above 1.176 anyway)
    // Vout = 1.176 * ((15*0.99) + (1.2 * 1.01)) / (1.2 * 1.01) - Vdac * 15 * 0.99 / (1.2 * 1.01)
    // Vout = 15.5849108911 - Val(DAC) * (1.24 / 4095) * (15 * 0.99 / (1.2 * 1.01))
    // Vout = 15.5849108911 - Val(DAC) * 0.00371015123
    // For 3210: 3.6753254428
    // for maximum (vdac never above 1.176 anyway)
    // Vout = 1.212 * ((15*1.01) + (1.2 * 0.99)) / (1.2 * 0.99) - Vdac * 15 * 1.01 / (1.2 * 0.99)
    // Vout = 16.6680606061 - Val(DAC) * (1.24 / 4095) * (15 * 1.01 / (1.2 * 0.99))
    // Vout = 16.6680606061 - Val(DAC) * 0.00386157052
    // For 3210: 4.2724192369
    setup_vbias_dac(3210);
    enable_ldo();
    _delay_ms(200);
    configure_adc_channel(ADC_CHANNEL_VBIAS, 0, TRUE);
    uint16_t voltage = compute_vbias_for_adc_value(get_averaged_adc_value(14));
    if (check_value_range(voltage, 3675, 4272) == FALSE)
    {
        testdprintf("- PROBLEM VBIAS GENERATION (LDO): %u\r\n", voltage);
        testdprintf_P(PSTR("  Likely suspects: U5 and passives around\r\n"));
        test_passed = FALSE;
    }
    else
    {
        testdprintf("- OK VBIAS GENERATION (LDO): %u\r\n", voltage);
    }
    
    /*******************************************************************/
    /*******************************************************************/
    /************** CHECK VBIAS GENERATION WITH STEPUP ****************/
    /*******************************************************************/
    /*******************************************************************/
    // For 1234 : min 11.006, max 11.903
    setup_vbias_dac(1234);
    enable_stepup();
    _delay_ms(200);
    configure_adc_channel(ADC_CHANNEL_VBIAS, 0, TRUE);
    voltage = compute_vbias_for_adc_value(get_averaged_adc_value(14));
    if (check_value_range(voltage, 11006, 11903) == FALSE)
    {
        testdprintf("- PROBLEM VBIAS GENERATION (STEPUP): %u\r\n", voltage);
        testdprintf_P(PSTR("  Likely suspects: U5 U1 and passives around\r\n"));
        test_passed = FALSE;
    }
    else
    {
        testdprintf("- OK VBIAS GENERATION (STEPUP): %u\r\n", voltage);
    }
    
    /*******************************************************************/
    /*******************************************************************/
    /********************** VBIAS QUENCHING TEST ***********************/
    /*******************************************************************/
    /*******************************************************************/
    RTC.CNT = 0;                                                    // Reset counter
    RTC.INTCTRL = 0;                                                // Disable Interrupts
    RTC.PER = 0xFFFF;                                               // Set max period for RTC
    RTC.CTRL = RTC_PRESCALER_DIV1024_gc;                            // Set 32768 / 1024 = 32Hz base frequency
    CLK.RTCCTRL = CLK_RTCSRC_TOSC32_gc | CLK_RTCEN_bm;              // Select 32kHz crystal for the RTC, enable it    
    disable_ldo();                                                  // Disable LDO
    disable_stepup();                                               // Disable stepup
    disable_vbias_dac();                                            // Disable DAC controlling the ldo    
    enable_vbias_quenching();                                       // Enable vbias quenching
    configure_adc_channel(ADC_CHANNEL_VBIAS, 0, TRUE);              // Set ADC Channel to vbias
    uint16_t measured_vbias = 2000;
    while (measured_vbias > 100)                                    // Wait until voltage is around 400mV
    {
        measured_vbias = get_averaged_adc_value(6);
    }
    uint16_t time_to_quench = RTC.CNT;                              // Measure the time it took to quench vbias
    if (RTC.CNT > 100)
    {
        testdprintf("- PROBLEM VBIAS QUENCHING: %u/32 secs\r\n", time_to_quench);
        testdprintf_P(PSTR("  Likely suspects: Q5 R37 R38\r\n"));
        test_passed = FALSE;
    }
    else
    {
        testdprintf("- OK VBIAS QUENCHING: %u/32 secs\r\n", time_to_quench);
    }    
    disable_vbias_quenching();
    
    /*******************************************************************/
    /*******************************************************************/
    /******************** CURRENT MEASUREMENT CHECK ********************/
    /*******************************************************************/
    /*******************************************************************/
    // Here we are using the opamp 3.3V output through the res mux at 100k
    // To force the opamp output at 3.3V, we set IN- to 0V
    // Hence, the 100k resistor pin will be connected to 0V through (1K2 + 100R) and (1K + 10K)
    // Equivalent resistor therefore is 1163, voltage at the node is 3.3V * 1163 / 101163 = 0.0379377836 volts
    // And measured current should be 0.0379377836 / 11000 = 3.44888942 * 10-6 A = 3.45uA
    // If we use 10k instead of 100k, voltage becomes 0.3438V, and current therefore should be 31uA
    // 
    // Vadc = I(A) * 1k * 100 * ampl
    // Vadc = I(A) * 100k * ampl
    // Val(ADC) * (1.24 / 2047) = I(A) * 100k * ampl
    // Val(ADC) = I(A) * 100k * ampl * 2047 / 1.24
    // For 3.45uA, approximately 569
    set_opampin_low();
    enable_cur_meas_mos();
    enable_feedback_mos();
    enable_res_mux(RES_100K, TRUE);
    delete_cur_measurement_offsets(); _delay_us(20);
    configure_adc_channel(ADC_CHANNEL_CUR, CUR_MES_1X, TRUE);
    uint16_t cur_measure_100k = cur_measurement_loop(16);    
    enable_res_mux(RES_10K, TRUE); _delay_us(20);
    uint16_t cur_measure_rest = cur_measurement_loop(13);
    enable_res_mux(RES_1K, TRUE); _delay_us(20);
    cur_measure_rest += cur_measurement_loop(13);
    enable_res_mux(RES_470, TRUE); _delay_us(20);
    cur_measure_rest += cur_measurement_loop(13);
    if ((check_value_range(cur_measure_100k, 540, 600) == FALSE) || (cur_measure_rest < 6100))
    {
        testdprintf("- PROBLEM CUR MEASUREMENT: %u & %u\r\n", cur_measure_100k, cur_measure_rest);
        testdprintf_P(PSTR("  Likely suspects: R3 Q1 R29 U2 U4 R13 R16 R14 R15 R29 Q3 U7 R21 R28 Q2 R19\r\n"));
        //print_compute_cur_formula(cur_measure);
        test_passed = FALSE;
    }
    else
    {
        testdprintf("- OK CUR MEASUREMENT: %u & %u\r\n", cur_measure_100k, cur_measure_rest);
    }
    disable_res_mux();
    disable_feedback_mos();    
    
    /*******************************************************************/
    /*******************************************************************/
    /************************ USB COMMS CHECK **************************/
    /*******************************************************************/
    /*******************************************************************/
    if(is_usb_enumerated() != TRUE)
    {
        testdprintf_P(PSTR("- PROBLEM USB COMMS: check CON1, U9 & U6\r\n"));
        test_passed = FALSE;
    }
    else
    {
        testdprintf_P(PSTR("- OK USB COMMS\r\n"));
    }
    
    if (test_passed == TRUE)
    {
        testdprintf_P(PSTR("\r\n--------------------------\r\n"));
        testdprintf_P(PSTR("--------------------------\r\n"));
        testdprintf_P(PSTR("--------TEST PASSED-------\r\n"));
        testdprintf_P(PSTR("--------------------------\r\n"));
        testdprintf_P(PSTR("--------------------------\r\n"));
        eeprom_write_byte((uint8_t*)EEP_FUNC_TEST_DONE_BOOL, EEPROM_BOOL_OK_VAL);
        init_calibration();
    } 
    else
    {
        testdprintf_P(PSTR("\r\n--------------------------\r\n"));
        testdprintf_P(PSTR("--------------------------\r\n"));
        testdprintf_P(PSTR("--------TEST FAILED-------\r\n"));
        testdprintf_P(PSTR("--------------------------\r\n"));
        testdprintf_P(PSTR("--------------------------\r\n"));
        while(1);
    }    
}

/*
 * To measure set voltages
 */
void ramp_bias_voltage_test(void)
{
    // This is the routine to check that we actually can provide a vbias within +-0.5% specifications
    // We are running this scenario in the worst case: 270Ohms resistor, ~17uF cap connected
    // We want to make sure that the oscillations induced to vbias via the capacitor don't
    // break our vbias setting algorithm.
    testdprintf_P(PSTR("-----------------------\r\n"));
    testdprintf_P(PSTR("Ramp Voltage Test\r\n\r\n"));
        
    uint16_t set_voltage, correct_voltage, agg_error = 0;    
    enable_bias_voltage(15000);
    _delay_ms(5000);
    disable_bias_voltage();
    enable_bias_voltage(VBIAS_MIN_V);
    for (uint16_t i = VBIAS_MIN_V; i <= get_max_vbias_voltage(); i+= 50)
    {
        set_voltage = update_bias_voltage(i);
        _delay_ms(1500);
        correct_voltage = compute_vbias_for_adc_value(get_averaged_adc_value(18));
        if (i > correct_voltage)
        {
            agg_error += i - correct_voltage;
        }
        else
        {
            agg_error += correct_voltage - i;
        }
        testdprintf("Call: %u, Set: %u, Measured: %u, Error Set: %d, Error Measured: %d\r\n", i, set_voltage, correct_voltage, correct_voltage - set_voltage, correct_voltage - i);
    }
    testdprintf_P(PSTR("-----------------------\r\n"));
    testdprintf("Accumulated error : %d\r\n", agg_error);
    testdprintf_P(PSTR("-----------------------\r\n"));    
    disable_bias_voltage();
}

void peak_to_peak_adc_noise_measurement_test(void)
{
    enable_bias_voltage(VBIAS_MIN_V);
    for (uint16_t i = VBIAS_MIN_V; i <= get_max_vbias_voltage(); i+= 50)
    {
        update_bias_voltage(i);
        _delay_ms(100);
        measure_peak_to_peak_on_channel(BIT_AVG_FINE, ADC_CHANNEL_VBIAS, 0);
    }
    
    disable_bias_voltage();
}

/*
 * Ramp voltage and measure the current
 */
void ramp_current_test(void)
{
    uint16_t cur_measure;
    
    testdprintf_P(PSTR("-----------------------\r\n"));
    testdprintf_P(PSTR("Ramp Current Test\r\n\r\n"));
    
    set_current_measurement_mode(CUR_MES_1X);
    enable_bias_voltage(VBIAS_MIN_V);
    for (uint16_t i = VBIAS_MIN_V; i <= get_max_vbias_voltage(); i+= 50)
    {
        update_bias_voltage(i);
        _delay_ms(10);
        cur_measure = cur_measurement_loop(16);
        print_compute_cur_formula(cur_measure);
        if (cur_measure >= 2047)
        {
            break;
        }        
    }
    
    disable_bias_voltage();
    disable_current_measurement_mode();
}

/*
 * Enable disable voltage test
 */
void voltage_settling_test(void)
{
    // Decomment the enable/disable_cur_most in vbias.c for debug   
    while(1)
    {
        enable_bias_voltage(2000);
        disable_cur_meas_mos();
        _delay_ms(333);
        disable_bias_voltage();
    }
}
