limpkin/capmeter/(commit log)

2015-05-14 adc code
2015-05-17 internal opamp resistance measurement calibration
2015-07-01 updated current measurement calibration & technique
2015-07-01 calibration values stored in eeprom
2015-07-01 using ADC & DAC calibration values from NVM
2015-07-01 updated bias voltage test, pre inc/dec
2015-07-02 dedicated calibration file
2015-07-02 dedicated functions for current and vbias estimates
2015-07-03 dedicated function for single ended voltage measurement
2015-07-03 finished current calibration procedure
2015-07-04 correct methode to measure frequency
    [main.c, measurement.c, vbias.c, vbias.h]
2015-07-05 rc32M calibration + bootloader
2015-07-22 correct vbias setting logic
    [adc.c, calibration.c, defines.h, main.c, vbias.c, vbias.h]
2015-07-25 correct code for update vbias when going down
    [adc.c, adc.h, automated_testing.c, automated_testing.h, calibration.c, calibration.h, conversions.c, conversions.h]
2015-07-26 new current measurement test for functional test
2015-07-27 correct values for functional test
    [adc.c, calibration.c, main.c, tests.c, utils.c, utils.h, vbias.c, vbias.h]
2015-07-27 reintroducing offsets for current measurement
2015-08-10 Added USB custom library. Device enumerates with PC (Linux)
2015-08-26 worwing capacitance measurements!
2015-09-06 using eeprom to store calibration values
2015-09-06 few changes for calibration commands
2015-09-06 final calibration commands, with date
2015-09-06 current measurement implemented
2015-09-07 capacitance measurement
2015-09-07 adding example of disabled button
2015-09-09 improvement for large capacitance readings
2015-09-22 added manual categories on x-Axis
2015-09-22 [app] minor fronted changes (buttons are at same height)
2015-09-29 average on data points for graph, oscillation voltage offset
2015-09-29 current characterization
2015-09-30 470R resistor
2015-09-30 new resistance measurement technique based on the osc frequency
2015-10-01 current calibration
2015-10-09 - allow scaling in X and Y directions - disable word highlighting and input in the console - show corresponding X label when hovering the graph, in the form of "X at [xlabelvalue]" - change "calibrat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
2015-10-10 changed button size
2015-10-10 * horizontally center align the top & bottom block on top/under the graph * vertically center align the block on the left * horizontally center the "capacitance meter" title
2015-10-10 current measurement graph
2015-10-11 current caracterization synced
2015-10-11 storing current calibration data
2015-10-11 adc to ideal adc curve smoothing
2015-10-11 adc correction done
2015-10-12 migrated all calibration storage into the capmeter
2015-10-13 finalizing current calibration
2015-10-19 - Rename the "calibrate capacitance" button to "Zero Capacitance" - Add another button under the MΩ text field named "Export Curve"
2015-10-21 [chromeapp] tiny ui changes – more beauty
2015-10-21 implemented null button code
2015-10-23 added some space for "Voltage [V]"
2015-11-27 measuring oscillator rise time
    [measurement.c, measurement.h]
2015-12-15 schematics aded
    [bom_capacitance_meter.xlsm]
